asmi84/kicad-projects/S7_Min_Enet/S7_Min_Enet.pdf

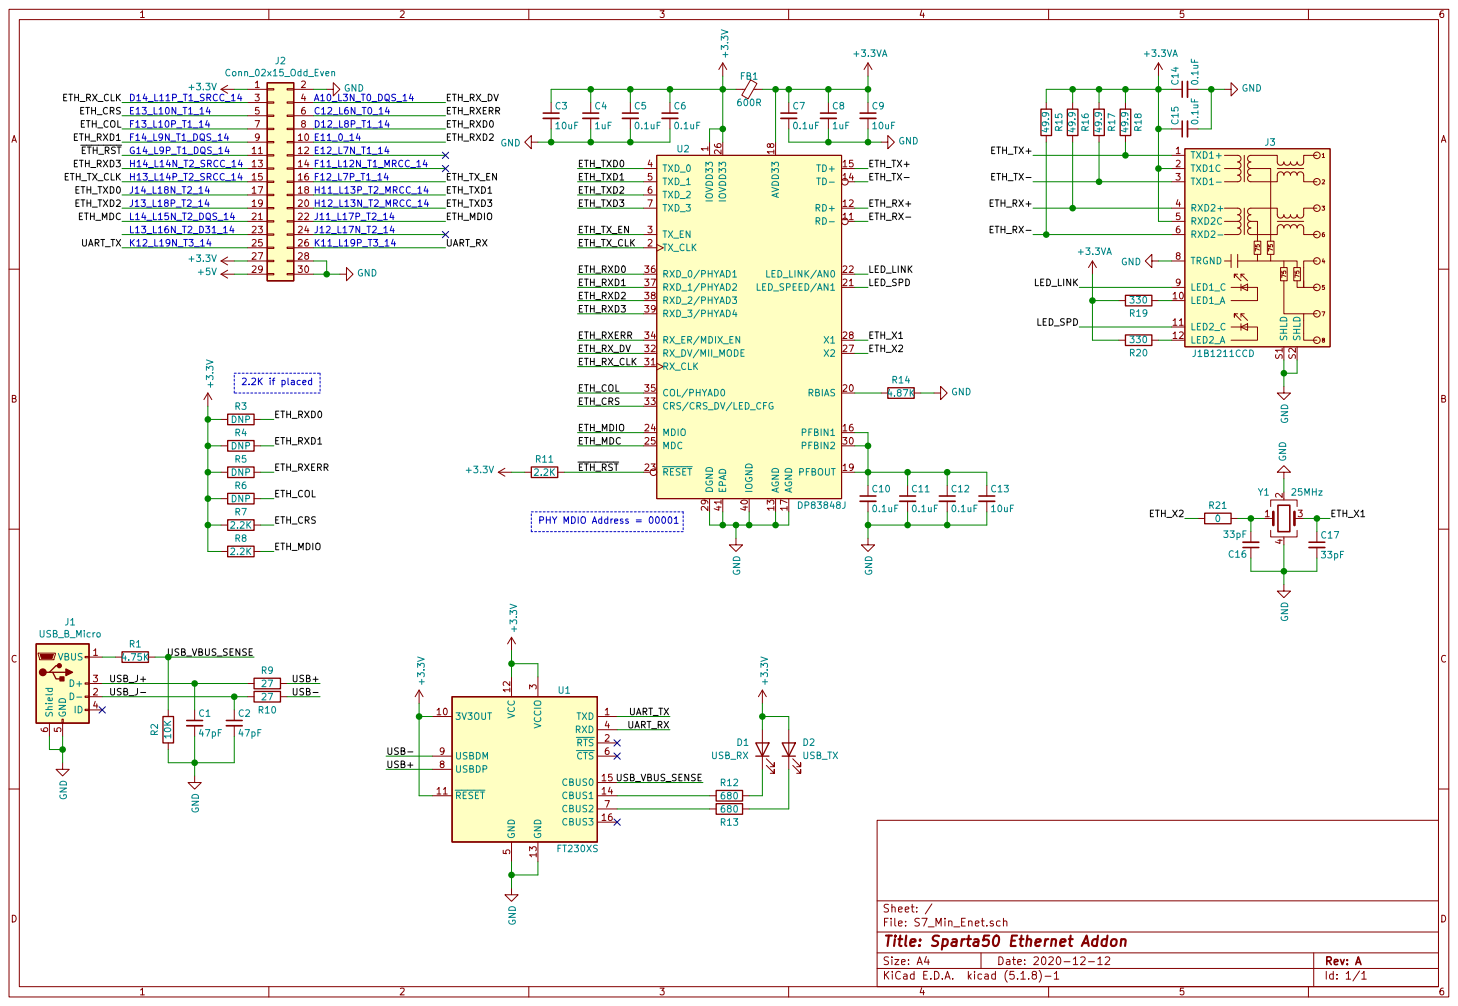
[picture p5: page 1]

1 RD- 11 RD+ 12 AGND 13 TD- 14 TD+ 15 PFBIN1 16 AGND 17 AVDD33 18 PFBOUT 19 TX_CLK 2 RBIAS 20

5 CTS 6 CBUS2 7 USBDP 8 USBDM 9 U1 FT230XS R5 GND

File: S7_Min_Enet.sch Sheet: /
Id: 1/1 Title: Sparta50 Ethernet Addon
