asmi84/kicad-projects/S7_Min/S7_Min.pdf

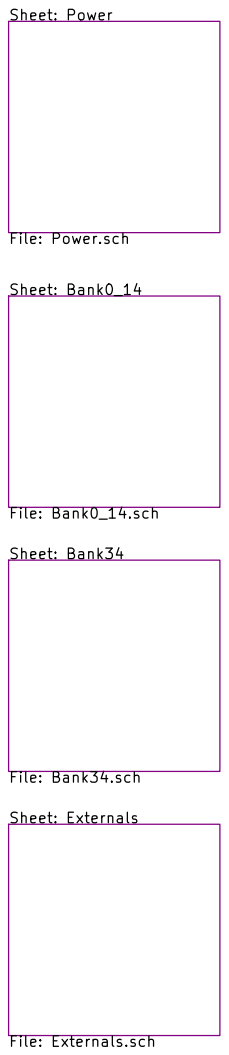
[picture p6: page 1]

Sheet: Power File: Power.sch Sheet: Bank0_14 File: Bank0_14.sch Sheet: Bank34 File: Bank34.sch Sheet: Externals File: Externals.sch

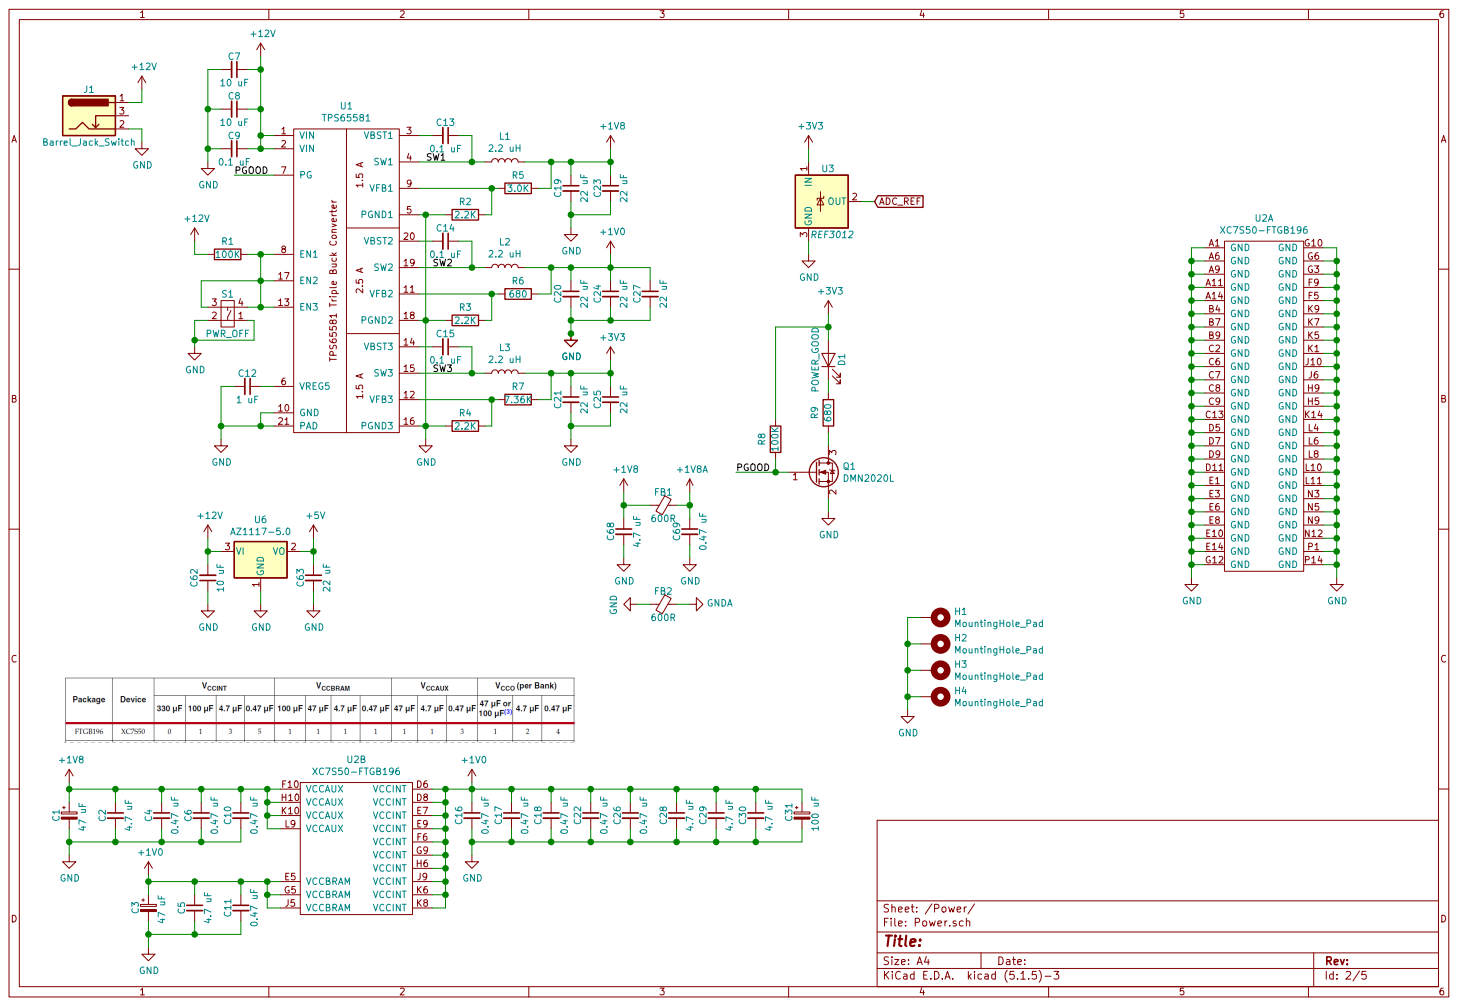
[picture p7: page 2]

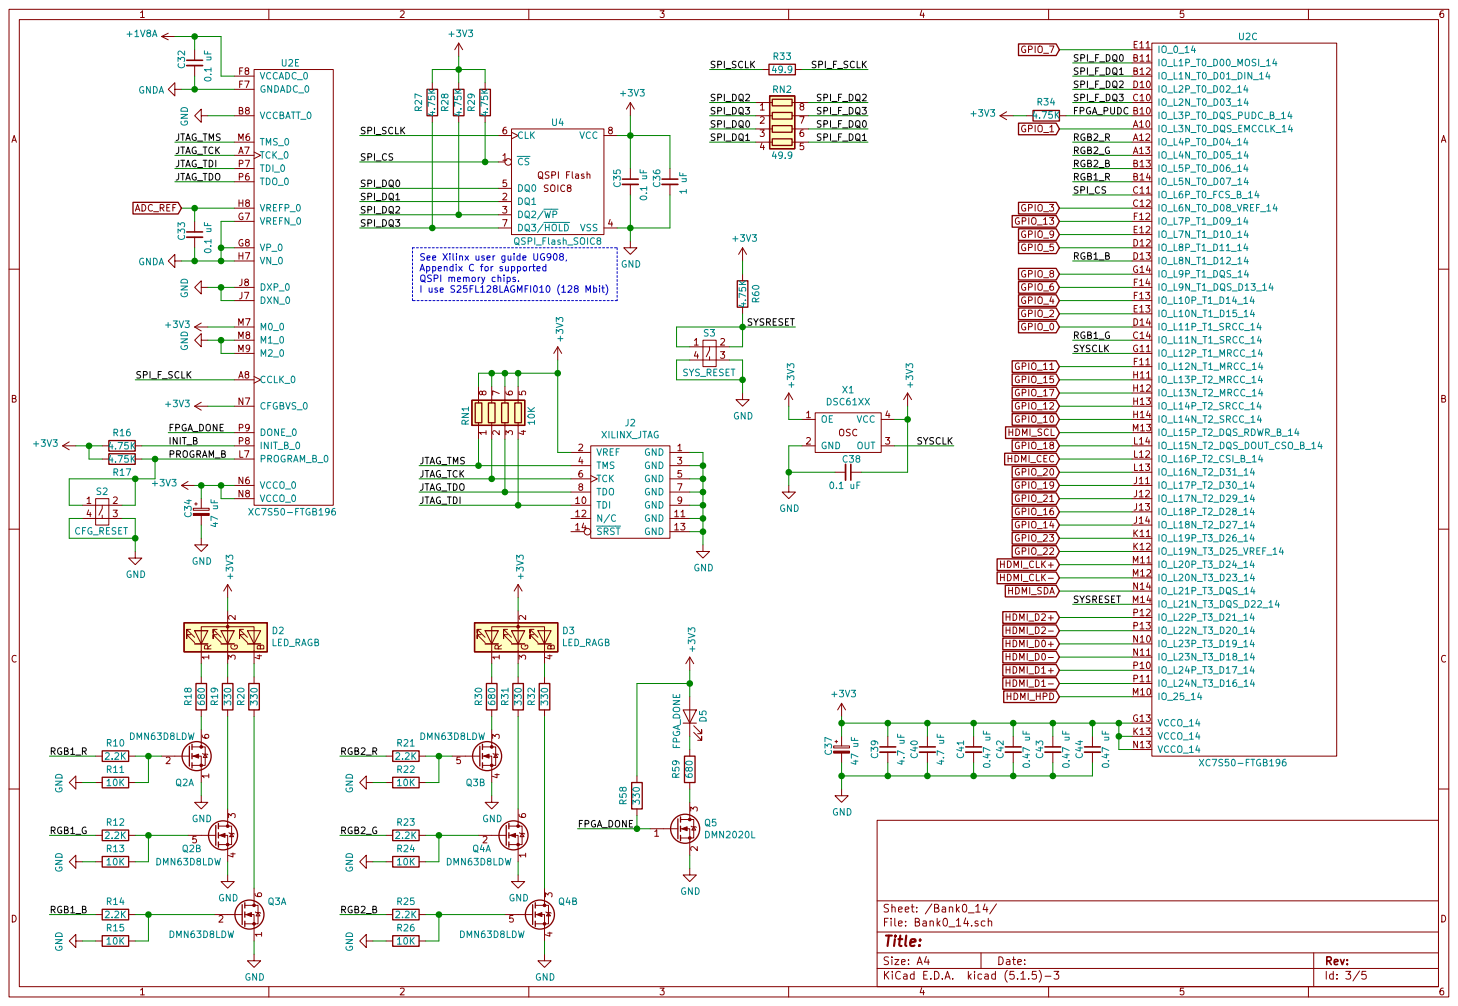
[picture p8: page 3]

See Xilinx user guide UG908,
Appendix C for supported
QSPI memory chips.
I use S25FL128LAGMFI010 (128 Mbit)

5 RN1 10K GND 1 TDI 10 GND 11 N/C 12 GND 13 SRST 14 VREF 2 GND 3 TMS 4 GND 5 TCK 6 GND 7 TDO 8 GND 9

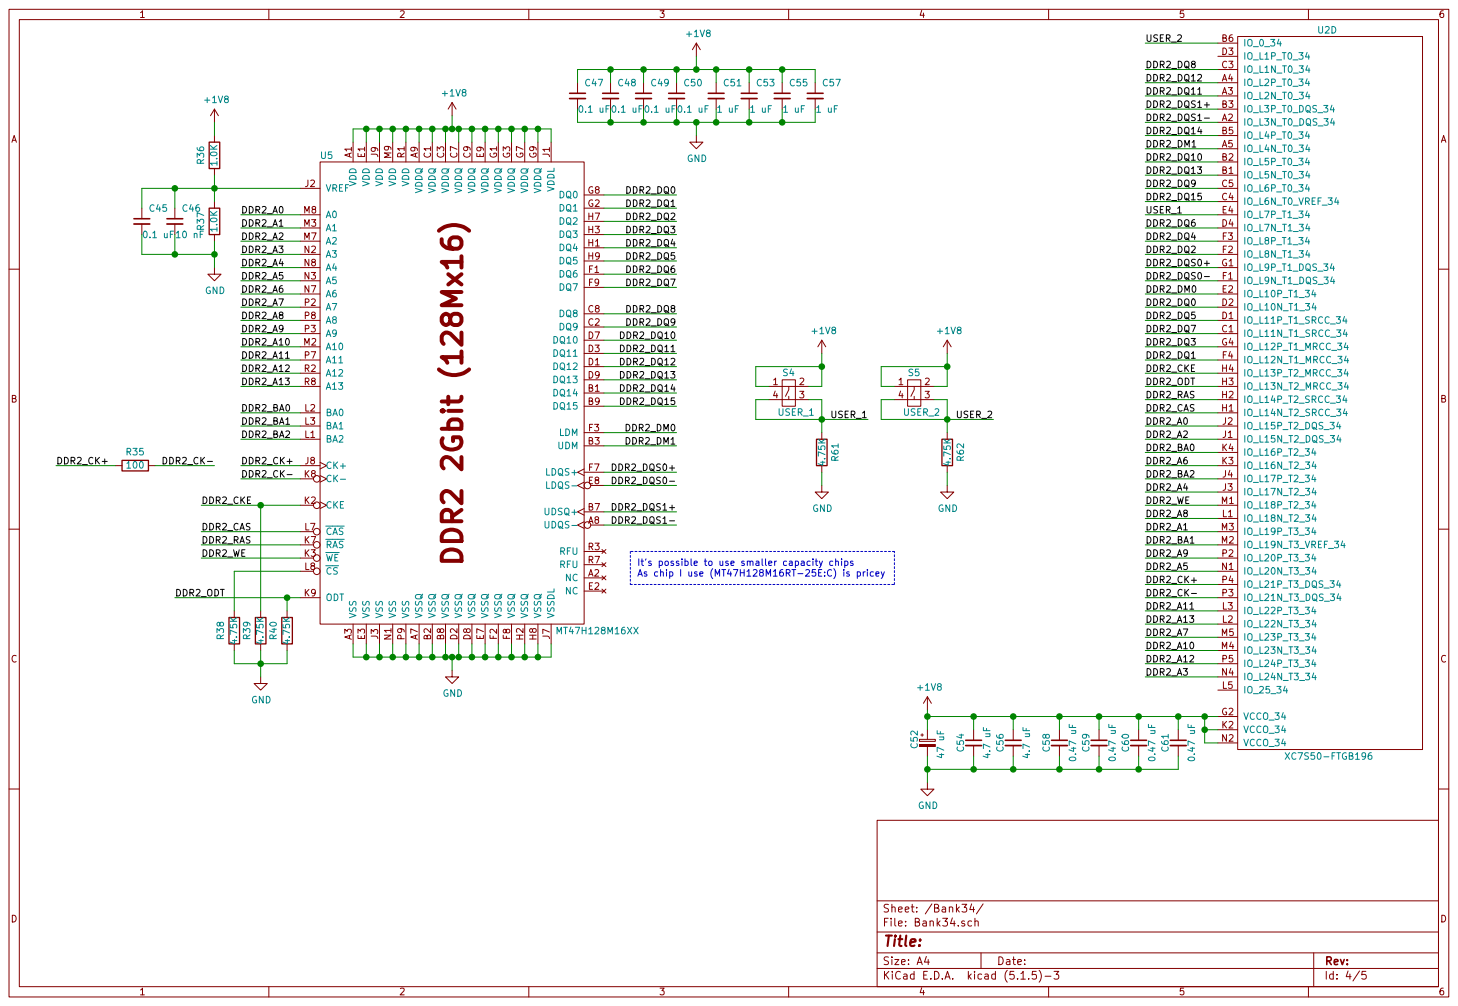
[picture p9: page 4]

It's possible to use smaller capacity chips
As chip I use (MT47H128M16RT-25E:C) is pricey

Id: 4/5 Title: File: Bank34.sch Sheet: /Bank34/

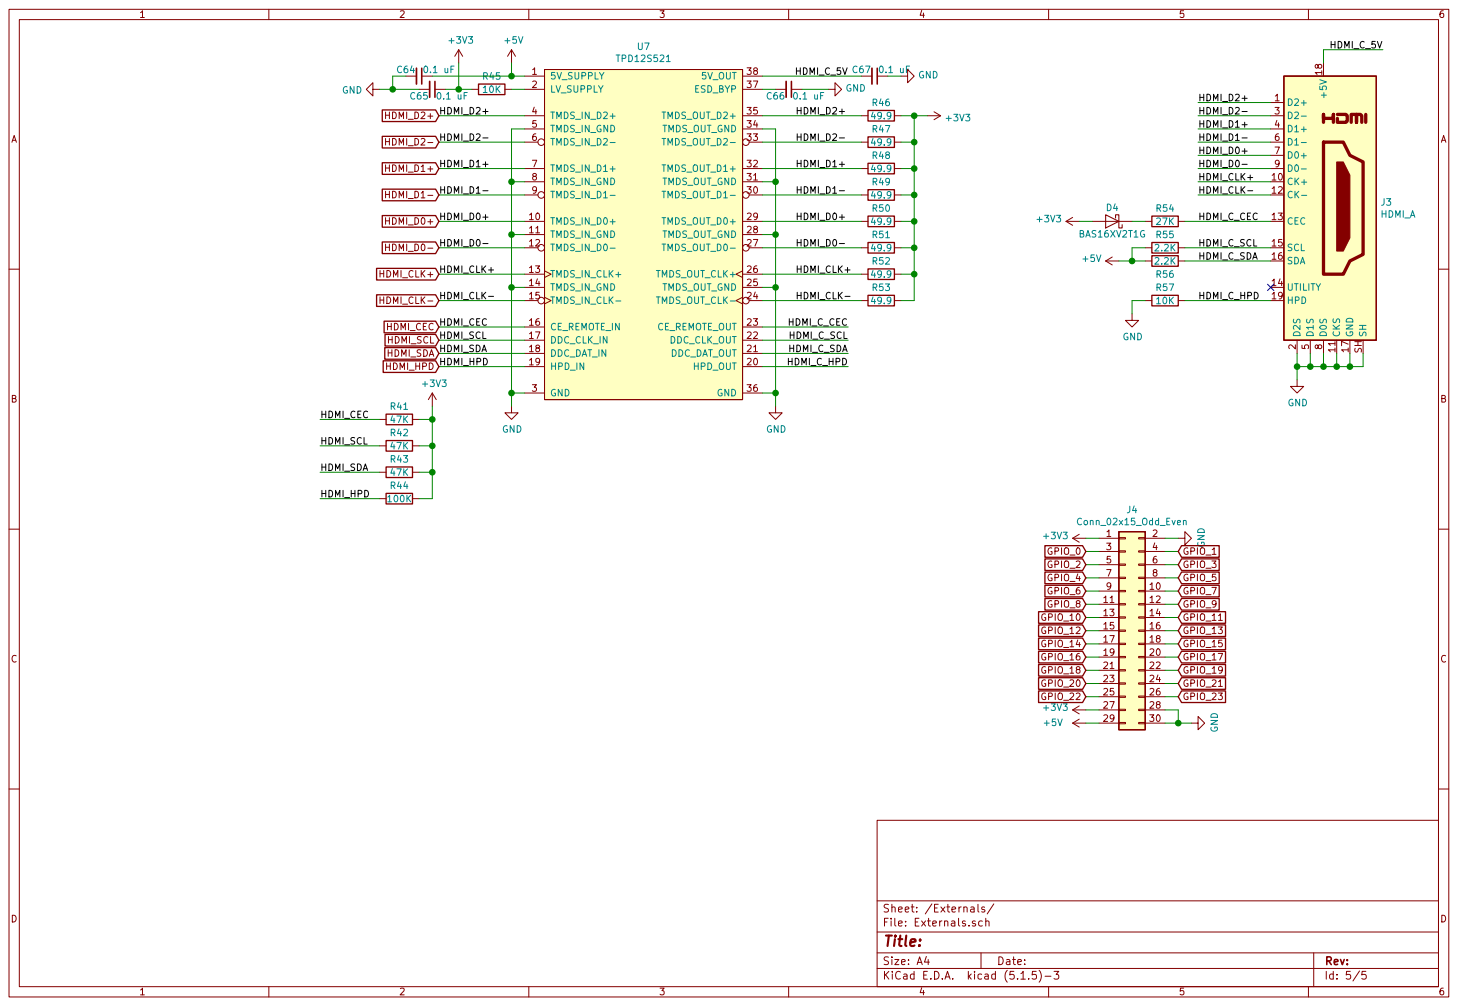
[picture p10: page 5]

Id: 5/5 Title: File: Externals.sch Sheet: /Externals/
