asmi84/kicad-projects/S7_Min_Enet/S7_Min_Enet.kicad_pcb

## KiCad design S7_Min_Enet/S7_Min_Enet.kicad_pcb (2021-01-11)

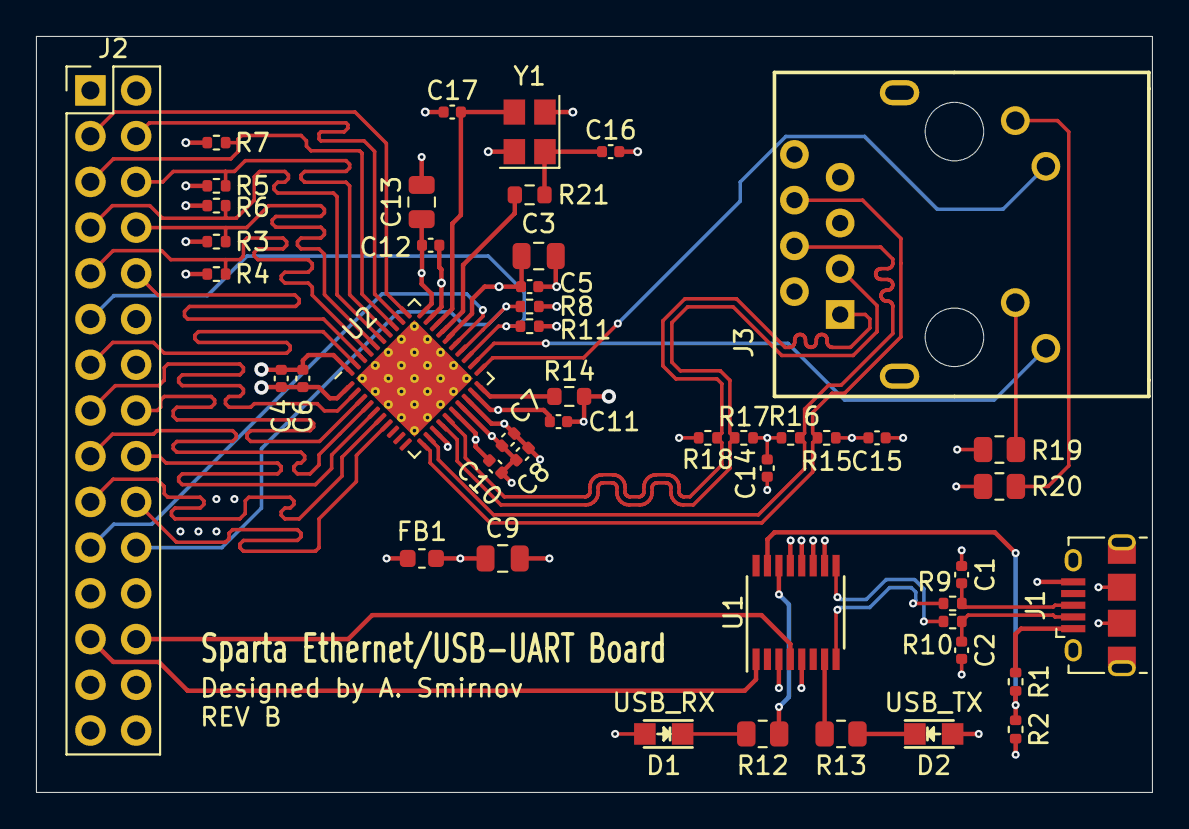
[picture p11: board S7_Min_Enet.kicad_pcb from above]

Board: 4 copper layers, 62.0 x 42.0 mm, 47 parts (0 on the bottom side), 46 nets.

Parts:
C1, C2: 47pF; C_0402_1005Metric
C3, C9, C13: 10uF; C_0805_2012Metric
C4, C8: 1uF; C_0402_1005Metric
C5, C6, C7, C10, C11, C12, C14, C15: 0.1uF; C_0402_1005Metric
C16, C17: 33pF; C_0402_1005Metric
D1: USB_RX; LED_0805
D2: USB_TX; LED_0805
FB1: 600R; L_0603_1608Metric
J1: USB_B_Micro; USB_Micro-B_Amphenol_10118194_Horizontal
J2: Conn_02x15_Odd_Even; PinHeader_2x15_P2.54mm_Vertical
J3: J1B1211CCD
R1: 4.75K; R_0402_1005Metric
R2: 10K; R_0402_1005Metric
R3, R4, R5, R6: DNP; R_0402_1005Metric
R7, R8, R11: 2.2K; R_0402_1005Metric
R9, R10: 27; R_0402_1005Metric
R12, R13: 680; R_0805_2012Metric
R14: 4.87K; R_0603_1608Metric
R15, R16, R17, R18: 49.9; R_0402_1005Metric
R19, R20: 330; R_0805_2012Metric
R21: 0; R_0603_1608Metric
U1: FT230XS; SSOP-16_3.9x4.9mm_P0.635mm
U2: DP83848J; QFN-40-1EP_6x6mm_P0.5mm_EP4.6x4.6mm_ThermalVias
Y1: 25MHz; Crystal_SMD_3225-4Pin_3.2x2.5mm

Connections:
+3.3VA: C7.1, C8.1, C9.1, C14.1, C15.1, FB1.1, J3.2, J3.5, R15.2, R16.2, R17.2, R18.2, R19.1, R20.1, U2.18
+3V3: C3.1, C4.1, C5.1, C6.1, D1.2, D2.2, FB1.2, J2.1, J2.27, R3.2, R4.2, R5.2, R6.2, R7.2, R8.2, R11.2, U1.3, U1.10, U1.11, U1.12, U2.1, U2.26
/ETH_COL: J2.7, R6.1, U2.35
/ETH_CRS: J2.5, R7.1, U2.33
/ETH_MDC: J2.21, U2.25
/ETH_MDIO: J2.22, R8.1, U2.24
/ETH_RX+: J3.4, R16.1, U2.12
/ETH_RX-: J3.6, R15.1, U2.11
/ETH_RXD0: J2.8, R3.1, U2.36
/ETH_RXD1: J2.9, R4.1, U2.37
/ETH_RXD2: J2.10, U2.38
/ETH_RXD3: J2.13, U2.39
/ETH_RXERR: J2.6, R5.1, U2.34
/ETH_RX_CLK: J2.3, U2.31
/ETH_RX_DV: J2.4, U2.32
/ETH_TX+: J3.1, R18.1, U2.15
/ETH_TX-: J3.3, R17.1, U2.14
/ETH_TXD0: J2.17, U2.4
/ETH_TXD1: J2.18, U2.5
/ETH_TXD2: J2.19, U2.6
/ETH_TXD3: J2.20, U2.7
/ETH_TX_CLK: J2.15, U2.2
/ETH_TX_EN: J2.16, U2.3
/ETH_X1: C17.1, U2.28, Y1.3
/ETH_X2: R21.2, U2.27
/LED_LINK: J3.9, U2.22
/LED_SPD: J3.11, U2.21
/UART_RX: J2.26, U1.4
/UART_TX: J2.25, U1.1
/USB+: R9.1, U1.8
/USB-: R10.1, U1.9
/USB_J+: C1.1, J1.3, R9.2
/USB_J-: C2.1, J1.2, R10.2
/USB_VBUS_SENSE: R1.1, R2.2, U1.15
/~ETH_RST: J2.11, R11.1, U2.23
GND: C1.2, C2.2, C3.2, C4.2, C5.2, C6.2, C7.2, C8.2, C9.2, C10.2, C11.2, C12.2, C13.2, C14.2, C15.2, C16.1, C17.2, J1.5, J1.6, J2.2, J2.28, J2.30, J3.8, J3.S1, J3.S2, R2.1, R14.1, U1.5, U1.13, U2.13, U2.17, U2.29, U2.40, U2.41, Y1.2, Y1.4
unnamed: C10.1, C11.1, C12.1, C13.1, U2.16, U2.19, U2.30
unnamed: C16.2, R21.1, Y1.1
unnamed: D1.1, R12.1
unnamed: D2.1, R13.1
unnamed: J1.1, R1.2
unnamed: J3.10, R19.2
unnamed: J3.12, R20.2
unnamed: R12.2, U1.14
unnamed: R13.2, U1.7
unnamed: R14.2, U2.20
