asmi84/kicad-projects/S7_Min/S7_Min.kicad_pcb

## KiCad design S7_Min/S7_Min.kicad_pcb (2020-12-16)

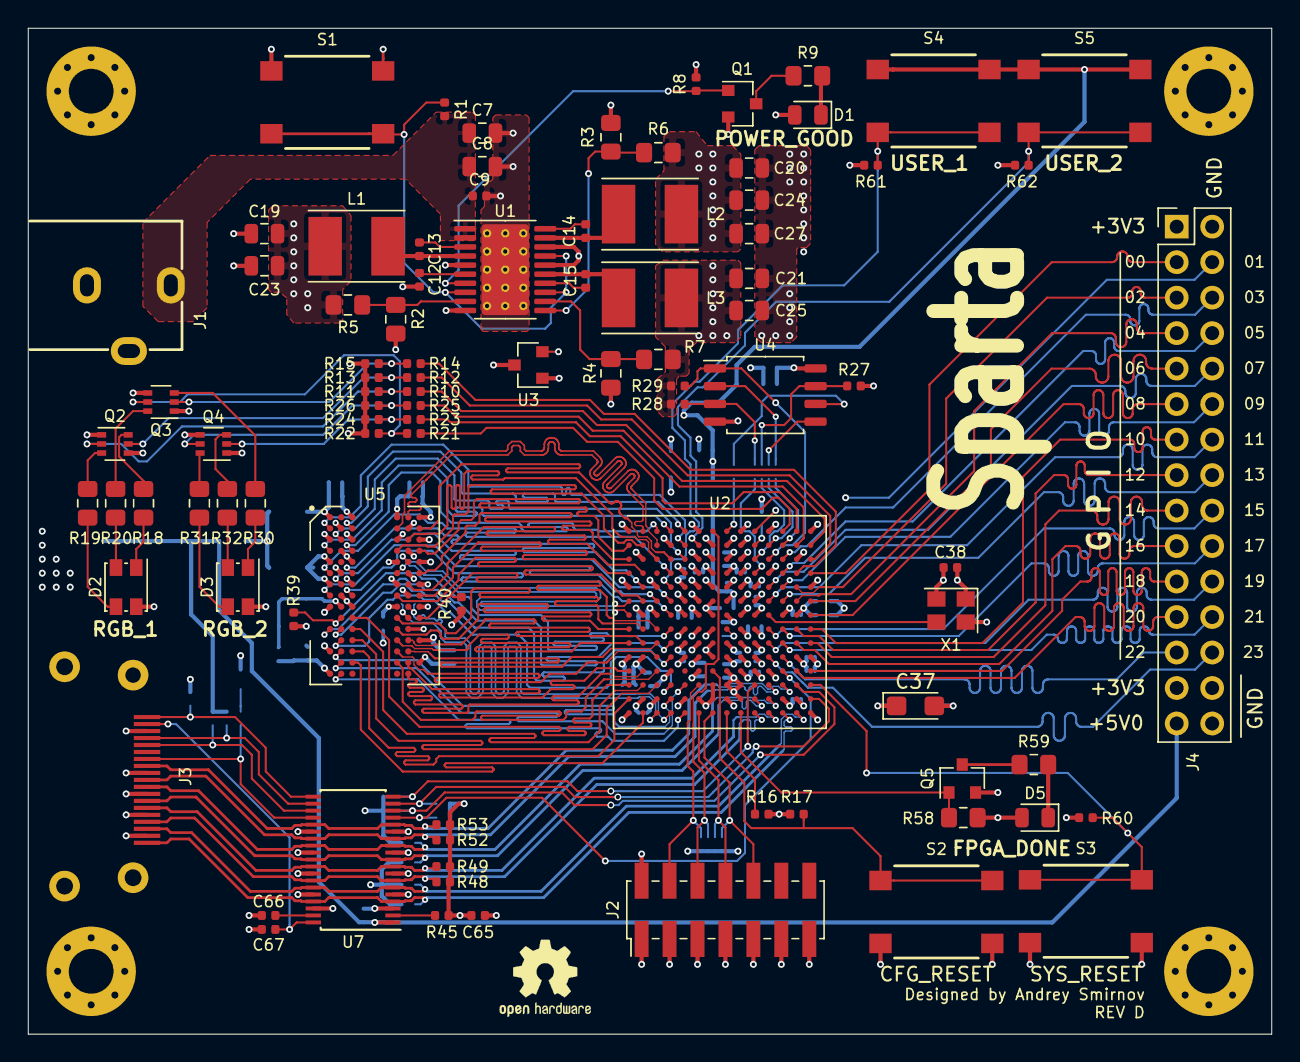
[picture p12: board S7_Min.kicad_pcb from above]

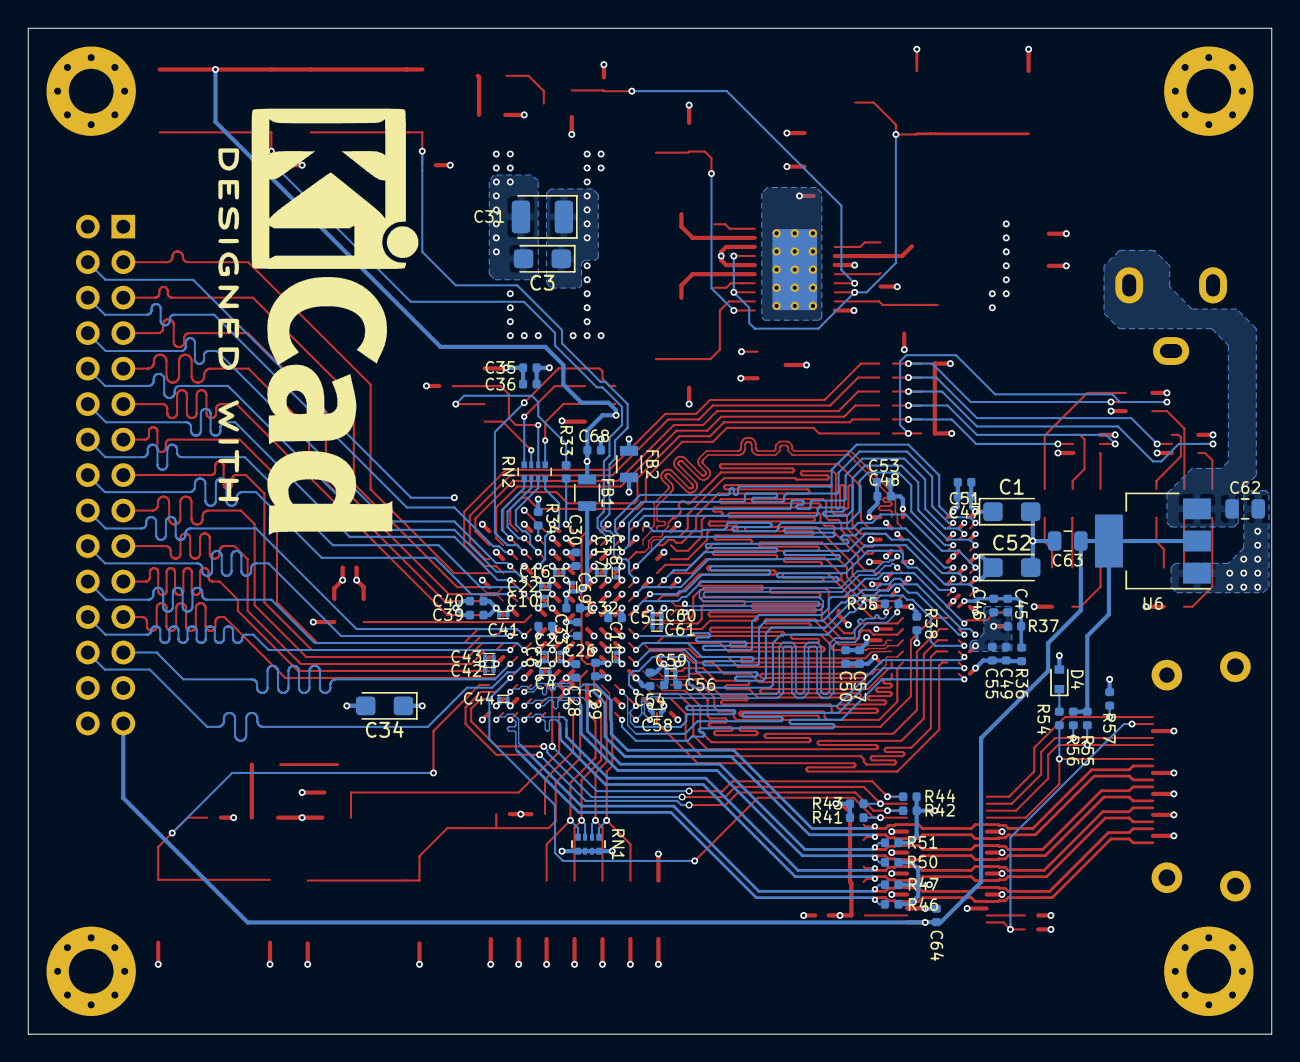
[picture p13: board S7_Min.kicad_pcb from below]

Board: 4 copper layers, 89.0 x 72.0 mm, 169 parts (74 on the bottom side), 164 nets.

Parts:
C1, C3, C34, C37, C52: 47 uF; CP_EIA-3216-18_Kemet-A
C2, C5, C28, C29, C30, C39, C40, C54, C56, C68: 4.7 uF; C_0402_1005Metric
C4, C6, C10, C11, C16, C17, C18, C22, C26, C41, C42, C43, C44, C58, C59, C60, C61, C69: 0.47 uF; C_0201_0603Metric
C7, C8, C62: 10 uF; C_0805_2012Metric
C9, C13, C14, C15, C32, C33, C35, C38, C45, C47, C48, C49, C50, C64, C65, C66, C67: 0.1 uF; C_0402_1005Metric
C12, C36, C51, C53, C55, C57: 1 uF; C_0402_1005Metric
C19, C20, C21, C23, C24, C25, C27, C63: 22 uF; C_0805_2012Metric
C31: 100 uF; CP_EIA-3528-15_AVX-H
C46: 10 nF; C_0402_1005Metric
D1: POWER_GOOD; LED_0805_2012Metric
D2, D3: LED_RAGB; LED_Kingbright_AAA3528ESGCT
D4: BAS16XV2T1G; D_SOD-523
D5: FPGA_DONE; LED_0805_2012Metric
FB1, FB2: 600R; L_0805
H1, H2, H3, H4: MountingHole_Pad; MountingHole_3.2mm_M3_Pad_Via
J1: Barrel_Jack_Switch; PJ_102B
J2: XILINX_JTAG; PinHeader_2x07_P2.00mm_Vertical_SMD
J3: HDMI_A; hdmi_type_a_10029449-111RLF
J4: Conn_02x15_Odd_Even; PinHeader_2x15_P2.54mm_Vertical
L1, L2, L3: 2.2 uH; L_Taiyo-Yuden_NR-50xx_HandSoldering
Q1, Q5: DMN2020L; SOT-23
Q2, Q3, Q4: DMN63D8LDW; SOT-363_SC-70-6
R1, R8, R44: 100K; R_0402_1005Metric
R2, R3, R4: 2.2K; R_0805_2012Metric_Pad1.15x1.40mm_HandSolder
R5: 3.0K; R_0805_2012Metric_Pad1.15x1.40mm_HandSolder
R6, R9, R18, R30, R59: 680; R_0805_2012Metric_Pad1.15x1.40mm_HandSolder
R7: 7.36K; R_0805_2012Metric_Pad1.15x1.40mm_HandSolder
R10, R12, R14, R21, R23, R25, R55, R56: 2.2K; R_0402_1005Metric
R11, R13, R15, R22, R24, R26, R45, R57: 10K; R_0402_1005Metric
R16, R17, R27, R28, R29, R34, R38, R39, R40, R60, R61, R62: 4.75K; R_0402_1005Metric
R19, R20, R31, R32, R58: 330; R_0805_2012Metric_Pad1.15x1.40mm_HandSolder
R33, R46, R47, R48, R49, R50, R51, R52, R53: 49.9; R_0402_1005Metric
R35: 100; R_0402_1005Metric
R36, R37: 1.0K; R_0402_1005Metric
R41, R42, R43: 47K; R_0402_1005Metric
R54: 27K; R_0402_1005Metric
RN1: 10K; R_Array_Convex_4x0402
RN2: 49.9; R_Array_Convex_4x0402
S1: PWR_OFF; B3FS_1010P
S2: CFG_RESET; B3FS_1010P
S3: SYS_RESET; B3FS_1010P
S4: USER_1; B3FS_1010P
S5: USER_2; B3FS_1010P
U1: TPS65581; HTSSOP-20-1EP_4.4x6.5mm_P0.65mm_EP3.4x6.5mm_Mask2.75x3.43mm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
U2: XC7S50-FTGB196; Xilinx_FTGB196
U3: REF3012; SOT-23
U4: QSPI_Flash_SOIC8; SOIC-8_5.275x5.275mm_P1.27mm
U5: MT47H128M16XX; BGA-84_9x15_9.0x12.5mm
U6: AZ1117-5.0; SOT-223-3_TabPin2
U7: TPD12S521; TSSOP-38_4.4x9.7mm_P0.5mm
X1: DSC61XX; Oscillator_SMD_Abracon_ASE-4Pin_3.2x2.5mm

Connections:
+1V0: C3.1, C5.1, C11.1, C16.1, C17.1, C18.1, C20.1, C22.1, C24.1, C26.1, C27.1, C28.1, C29.1, C30.1, C31.1, L2.2, R6.1, U2.D6, U2.D8, U2.E5, U2.E7, U2.E9, U2.F6, U2.G5, U2.G9, U2.H6, U2.J5, U2.J9, U2.K6, U2.K8
+1V8: C1.1, C2.1, C4.1, C6.1, C10.1, C19.1, C23.1, C47.1, C48.1, C49.1, C50.1, C51.1, C52.1, C53.1, C54.1, C55.1, C56.1, C57.1, C58.1, C59.1, C60.1, C61.1, C68.1, FB1.2, L1.2, R5.1, R36.2, S4.1, S4.2, S5.1, S5.2, U2.F10, U2.G2, U2.H10, U2.K2, U2.K10, U2.L9, U2.N2, U5.A1, U5.A9, U5.C1, U5.C3, U5.C7, U5.C9, U5.E1, U5.E9, U5.G1, U5.G3, U5.G7, U5.G9, U5.J1, U5.J9, U5.M9, U5.R1
+1V8A: C32.1, C69.1, FB1.1, U2.F8
+3V3: C21.1, C25.1, C34.1, C35.1, C36.1, C37.1, C38.1, C39.1, C40.1, C41.1, C42.1, C43.1, C44.1, C65.1, D1.2, D2.2, D3.2, D4.2, D5.2, J2.2, J4.1, J4.27, L3.2, R7.1, R8.2, R16.2, R17.2, R27.2, R28.2, R29.2, R34.1, R41.1, R42.1, R43.1, R44.1, R45.2, R46.1, R47.1, R48.1, R49.1, R50.1, R51.1, R52.1, R53.1, R58.2, R60.1, RN1.5, RN1.6, RN1.7, RN1.8, U2.G13, U2.K13, U2.M7, U2.N6, U2.N7, U2.N8, U2.N13, U3.1, U4.8, X1.1, X1.4
+5V: C63.1, C64.1, J4.29, R55.2, R56.2, U6.2, U7.1
+12V: C7.1, C8.1, C9.1, C62.2, J1.1, R1.2, U1.1, U1.2, U6.3
/Bank0_14/FPGA_DONE: Q5.1, R58.1, U2.P9
/Bank0_14/FPGA_PUDC: R34.2, U2.B10
/Bank0_14/INIT_B: R16.1, U2.P8
/Bank0_14/JTAG_TCK: J2.6, RN1.2, U2.A7
/Bank0_14/JTAG_TDI: J2.10, RN1.4, U2.P7
/Bank0_14/JTAG_TDO: J2.8, RN1.3, U2.P6
/Bank0_14/JTAG_TMS: J2.4, RN1.1, U2.M6
/Bank0_14/PROGRAM_B: R17.1, S2.1, S2.2, U2.L7
/Bank0_14/RGB1_B: R14.2, U2.D13
/Bank0_14/RGB1_G: R12.2, U2.C14
/Bank0_14/RGB1_R: R10.2, U2.B14
/Bank0_14/RGB2_B: R25.2, U2.B13
/Bank0_14/RGB2_G: R23.2, U2.A13
/Bank0_14/RGB2_R: R21.2, U2.A12
/Bank0_14/SPI_CS: R29.1, U2.C11, U4.1
/Bank0_14/SPI_DQ0: RN2.3, U4.5
/Bank0_14/SPI_DQ1: RN2.4, U4.2
/Bank0_14/SPI_DQ2: R28.1, RN2.1, U4.3
/Bank0_14/SPI_DQ3: R27.1, RN2.2, U4.7
/Bank0_14/SPI_F_DQ0: RN2.6, U2.B11
/Bank0_14/SPI_F_DQ1: RN2.5, U2.B12
/Bank0_14/SPI_F_DQ2: RN2.8, U2.D10
/Bank0_14/SPI_F_DQ3: RN2.7, U2.C10
/Bank0_14/SPI_F_SCLK: R33.1, U2.A8
/Bank0_14/SPI_SCLK: R33.2, U4.6
/Bank0_14/SYSCLK: U2.G11, X1.3
/Bank0_14/SYSRESET: R60.2, S3.1, S3.2, U2.M14
/Bank34/DDR2_A0: U2.J2, U5.M8
/Bank34/DDR2_A1: U2.M3, U5.M3
/Bank34/DDR2_A2: U2.J1, U5.M7
/Bank34/DDR2_A3: U2.N4, U5.N2
/Bank34/DDR2_A4: U2.J3, U5.N8
/Bank34/DDR2_A5: U2.N1, U5.N3
/Bank34/DDR2_A6: U2.K3, U5.N7
/Bank34/DDR2_A7: U2.M5, U5.P2
/Bank34/DDR2_A8: U2.L1, U5.P8
/Bank34/DDR2_A9: U2.P2, U5.P3
/Bank34/DDR2_A10: U2.M4, U5.M2
/Bank34/DDR2_A11: U2.L3, U5.P7
/Bank34/DDR2_A12: U2.P5, U5.R2
/Bank34/DDR2_A13: U2.L2, U5.R8
/Bank34/DDR2_BA0: U2.K4, U5.L2
/Bank34/DDR2_BA1: U2.M2, U5.L3
/Bank34/DDR2_BA2: U2.J4, U5.L1
/Bank34/DDR2_CAS: U2.H1, U5.L7
/Bank34/DDR2_CK+: R35.1, U2.P4, U5.J8
/Bank34/DDR2_CK-: R35.2, U2.P3, U5.K8
/Bank34/DDR2_CKE: R39.2, U2.H4, U5.K2
/Bank34/DDR2_DM0: U2.E2, U5.F3
/Bank34/DDR2_DM1: U2.A5, U5.B3
/Bank34/DDR2_DQ0: U2.D2, U5.G8
/Bank34/DDR2_DQ1: U2.F4, U5.G2
/Bank34/DDR2_DQ2: U2.F2, U5.H7
/Bank34/DDR2_DQ3: U2.G4, U5.H3
/Bank34/DDR2_DQ4: U2.F3, U5.H1
/Bank34/DDR2_DQ5: U2.D1, U5.H9
/Bank34/DDR2_DQ6: U2.D4, U5.F1
/Bank34/DDR2_DQ7: U2.C1, U5.F9
/Bank34/DDR2_DQ8: U2.C3, U5.C8
/Bank34/DDR2_DQ9: U2.C5, U5.C2
/Bank34/DDR2_DQ10: U2.B2, U5.D7
/Bank34/DDR2_DQ11: U2.A3, U5.D3
/Bank34/DDR2_DQ12: U2.A4, U5.D1
/Bank34/DDR2_DQ13: U2.B1, U5.D9
/Bank34/DDR2_DQ14: U2.B5, U5.B1
/Bank34/DDR2_DQ15: U2.C4, U5.B9
/Bank34/DDR2_DQS0+: U2.G1, U5.F7
/Bank34/DDR2_DQS0-: U2.F1, U5.E8
/Bank34/DDR2_DQS1+: U2.B3, U5.B7
/Bank34/DDR2_DQS1-: U2.A2, U5.A8
/Bank34/DDR2_ODT: R40.2, U2.H3, U5.K9
/Bank34/DDR2_RAS: U2.H2, U5.K7
/Bank34/DDR2_WE: U2.M1, U5.K3
/Bank34/USER_1: R61.1, S4.3, S4.4, U2.E4
/Bank34/USER_2: R62.1, S5.3, S5.4, U2.B6
/Externals/HDMI_C_5V: C67.2, J3.18, U7.38
/Externals/HDMI_C_CEC: J3.13, R54.1, U7.23
/Externals/HDMI_C_HPD: J3.19, R57.1, U7.20
/Externals/HDMI_C_SCL: J3.15, R55.1, U7.22
/Externals/HDMI_C_SDA: J3.16, R56.1, U7.21
/Power/PGOOD: Q1.1, R8.1, U1.7
/Power/SW1: C13.1, L1.1, U1.4
/Power/SW2: C14.1, L2.1, U1.19
/Power/SW3: C15.1, L3.1, U1.15
ADC_REF: C33.1, U2.H8, U3.2
GND: C1.2, C2.2, C3.2, C4.2, C5.2, C6.2, C7.2, C8.2, C9.2, C10.2, C11.2, C12.2, C16.2, C17.2, C18.2, C19.2, C20.2, C21.2, C22.2, C23.2, C24.2, C25.2, C26.2, C27.2, C28.2, C29.2, C30.2, C31.2, C34.2, C35.2, C36.2, C37.2, C38.2, C39.2, C40.2, C41.2, C42.2, C43.2, C44.2, C45.2, C46.2, C47.2, C48.2, C49.2, C50.2, C51.2, C52.2, C53.2, C54.2, C55.2, C56.2, C57.2, C58.2, C59.2, C60.2, C61.2, C62.1, C63.2, C64.2, C65.2, C66.1, C67.1, C68.2, C69.2, FB2.2, H1.1, H2.1, H3.1, H4.1, J1.2, J2.1, J2.3, J2.5, J2.7, J2.9, J2.11, J2.13, J3.2, J3.5, J3.8, J3.11, J3.17, J3.SH, J4.2, J4.28, J4.30, Q1.2, Q2.1, Q2.4, Q3.1, Q3.4, Q4.1, Q4.4, Q5.2, R2.2, R3.2, R4.2, R11.2, R13.2, R15.2, R22.2, R24.2, R26.2, R37.1, R38.1, R39.1, R40.1, R57.2, R61.2, R62.2, S1.1, S1.2, S2.3, S2.4, S3.3, S3.4, U1.5, U1.10, U1.16, U1.18, U1.21, U2.A1, U2.A6, U2.A9, U2.A11, U2.A14, U2.B4, U2.B7, U2.B8, U2.B9, U2.C2, U2.C6, U2.C7, U2.C8, U2.C9, U2.C13, U2.D5, U2.D7, U2.D9, U2.D11, U2.E1, U2.E3, U2.E6, U2.E8, U2.E10, U2.E14, U2.F5, U2.F9, U2.G3, U2.G6, U2.G10, U2.G12, U2.H5, U2.H9, U2.J6, U2.J7, U2.J8, U2.J10, U2.K1, U2.K5, U2.K7, U2.K9, U2.K14, U2.L4, U2.L6, U2.L8, U2.L10, U2.L11, U2.M8, U2.M9, U2.N3, U2.N5, U2.N9, U2.N12, U2.P1, U2.P14, U3.3, U4.4, U5.A3, U5.A7, U5.B2, U5.B8, U5.D2, U5.D8, U5.E3, U5.E7, U5.F2, U5.F8, U5.H2, U5.H8, U5.J3, U5.J7, U5.N1, U5.P9, U6.1, U7.3, U7.5, U7.8, U7.11, U7.14, U7.25, U7.28, U7.31, U7.34, U7.36, X1.2
GNDA: C32.2, C33.2, FB2.1, U2.F7, U2.G7, U2.G8, U2.H7
GPIO_0: J4.3, U2.D14
GPIO_1: J4.4, U2.A10
GPIO_2: J4.5, U2.E13
GPIO_3: J4.6, U2.C12
GPIO_4: J4.7, U2.F13
GPIO_5: J4.8, U2.D12
GPIO_6: J4.9, U2.F14
GPIO_7: J4.10, U2.E11
GPIO_8: J4.11, U2.G14
GPIO_9: J4.12, U2.E12
GPIO_10: J4.13, U2.H14
GPIO_11: J4.14, U2.F11
GPIO_12: J4.15, U2.H13
GPIO_13: J4.16, U2.F12
GPIO_14: J4.17, U2.J14
GPIO_15: J4.18, U2.H11
GPIO_16: J4.19, U2.J13
GPIO_17: J4.20, U2.H12
GPIO_18: J4.21, U2.L14
GPIO_19: J4.22, U2.J11
GPIO_20: J4.23, U2.L13
GPIO_21: J4.24, U2.J12
GPIO_22: J4.25, U2.K12
GPIO_23: J4.26, U2.K11
HDMI_CEC: R41.2, U2.L12, U7.16
HDMI_CLK+: J3.10, R52.2, U2.M11, U7.13, U7.26
HDMI_CLK-: J3.12, R53.2, U2.M12, U7.15, U7.24
HDMI_D0+: J3.7, R50.2, U2.N10, U7.10, U7.29
HDMI_D0-: J3.9, R51.2, U2.N11, U7.12, U7.27
HDMI_D1+: J3.4, R48.2, U2.P10, U7.7, U7.32
HDMI_D1-: J3.6, R49.2, U2.P11, U7.9, U7.30
HDMI_D2+: J3.1, R46.2, U2.P12, U7.4, U7.35
HDMI_D2-: J3.3, R47.2, U2.P13, U7.6, U7.33
HDMI_HPD: R44.2, U2.M10, U7.19
HDMI_SCL: R42.2, U2.M13, U7.17
HDMI_SDA: R43.2, U2.N14, U7.18
unnamed: C12.1, U1.6
unnamed: C13.2, U1.3
unnamed: C14.2, U1.20
unnamed: C15.2, U1.14
unnamed: C45.1, C46.1, R36.1, R37.2, U5.J2
unnamed: C66.2, U7.37
unnamed: D1.1, R9.2
unnamed: D2.1, R18.1
unnamed: D2.3, R19.1
unnamed: D2.4, R20.1
unnamed: D3.1, R30.1
unnamed: D3.3, R31.1
unnamed: D3.4, R32.1
unnamed: D4.1, R54.2
unnamed: D5.1, R59.2
unnamed: Q1.3, R9.1
unnamed: Q2.2, R10.1, R11.1
unnamed: Q2.3, R19.2
unnamed: Q2.5, R12.1, R13.1
unnamed: Q2.6, R18.2
unnamed: Q3.2, R14.1, R15.1
unnamed: Q3.3, R30.2
unnamed: Q3.5, R21.1, R22.1
unnamed: Q3.6, R20.2
unnamed: Q4.2, R23.1, R24.1
unnamed: Q4.3, R32.2
unnamed: Q4.5, R25.1, R26.1
unnamed: Q4.6, R31.2
unnamed: Q5.3, R59.1
unnamed: R1.1, S1.3, S1.4, U1.8, U1.13, U1.17
unnamed: R2.1, R5.2, U1.9
unnamed: R3.1, R6.2, U1.11
unnamed: R4.1, R7.2, U1.12
unnamed: R38.2, U5.L8
unnamed: R45.1, U7.2
