asmi84/kicad-projects/(commit log)

2019-11-04 DDR2 layout WIP
    [Bank34.sch, S7_Min.kicad_pcb]
2019-11-04 3D models setup
    [S7_Min.kicad_pcb]
2019-11-04 updated footprints from library
    [S7_Min.kicad_pcb]
2019-11-04 more DDR2 WIP
    [Bank34.sch, S7_Min.kicad_pcb]
2019-11-04 DDR2 interface mostly completed
    [Bank0_14.sch, S7_Min.kicad_pcb]
2019-11-04 updated board to user custom footprint for 0201 caps
    [Bank0_14.sch, Bank34.sch, Power.sch, S7_Min.kicad_pcb]
2019-11-05 updated board with new 0201 footprint
    [S7_Min.kicad_pcb]
2019-11-05 added HDMI TX into schematics
    [Bank0_14.sch, Bank34.sch, Externals.sch, Power.sch, S7_Min.sch]
2019-11-06 changed HDMI connector footprint to use custom one
    [Externals.sch]
2019-11-06 connected HDMI connector's shield to GND
    [Externals.sch]
2019-12-10 changed package of 2 ADC capacitors to 0402 from 0201 to eliminate a BOM line
    [Bank0_14.sch, Bank34.sch, Externals.sch, Power.sch, S7_Min.kicad_pcb, S7_Min.sch]
2019-12-13 Layout is completed, DRC passed, first pass on a silk layers
    [Bank0_14.sch, Bank34.sch, Externals.sch, Power.sch, S7_Min.kicad_pcb]
2019-12-13 Silk ready
    [S7_Min.kicad_pcb]
2019-12-13 Replaces 47 uF caps footprint to polarized (tantalum)
    [Bank0_14.sch, Bank34.sch, Power.sch, S7_Min.kicad_pcb]
2019-12-13 REV A Ordered
    [S7_Min.kicad_pcb]
2019-12-13 Added schematic PDF
2019-12-13 added silkscreen labels to buttons "CFG_RESET" and "SYS_RESET"
    [S7_Min.kicad_pcb]
2019-12-24 fixed the layout after adding missing PAD pin to TPS65581 symbol :facepalm: added some exposed ground on the bottom side to improve thermals.
    [Power.sch, S7_Min.kicad_pcb]
2019-12-28 REV B Gerbers added
2020-01-27 REV C: - fixed power disable button connections (:facepalm:) - "FPGA_DONE" and "POWER_GOOD" LEDs were connected backwards
    [Bank0_14.sch, Bank34.sch, Externals.sch, Power.sch, S7_Min.kicad_pcb]
2020-01-27 updated schematics PDF, added assembly document
2020-12-07 added s7 min enet addon board
    [S7_Min_Enet.kicad_pcb, S7_Min_Enet.sch]
2020-12-16 completed rev A for Ethernet board
    [S7_Min_Enet.kicad_pcb, S7_Min_Enet.sch]
2020-12-16 matched length of all GPIO traces to 40.7±0.1 mm
    [S7_Min.kicad_pcb]
2020-12-16 Added gerbers for rev D main board and rev A ethernet board, schematic PDF for ethernet
    [S7_Min.kicad_pcb, S7_Min_Enet.kicad_pcb]
2020-12-24 added assembly file
2020-12-25 fixed assembly file
2020-12-25 revision B - fixed USB connection
    [S7_Min_Enet.kicad_pcb, S7_Min_Enet.sch]
2021-01-11 made some resistors DNP, updated schematics and assembly docs
    [S7_Min_Enet.kicad_pcb, S7_Min_Enet.sch]
